tomcombriat/TES_Aurora/hardware/v1/v1.kicad_pcb

## KiCad design hardware/v1/v1.kicad_pcb (2025-04-08)

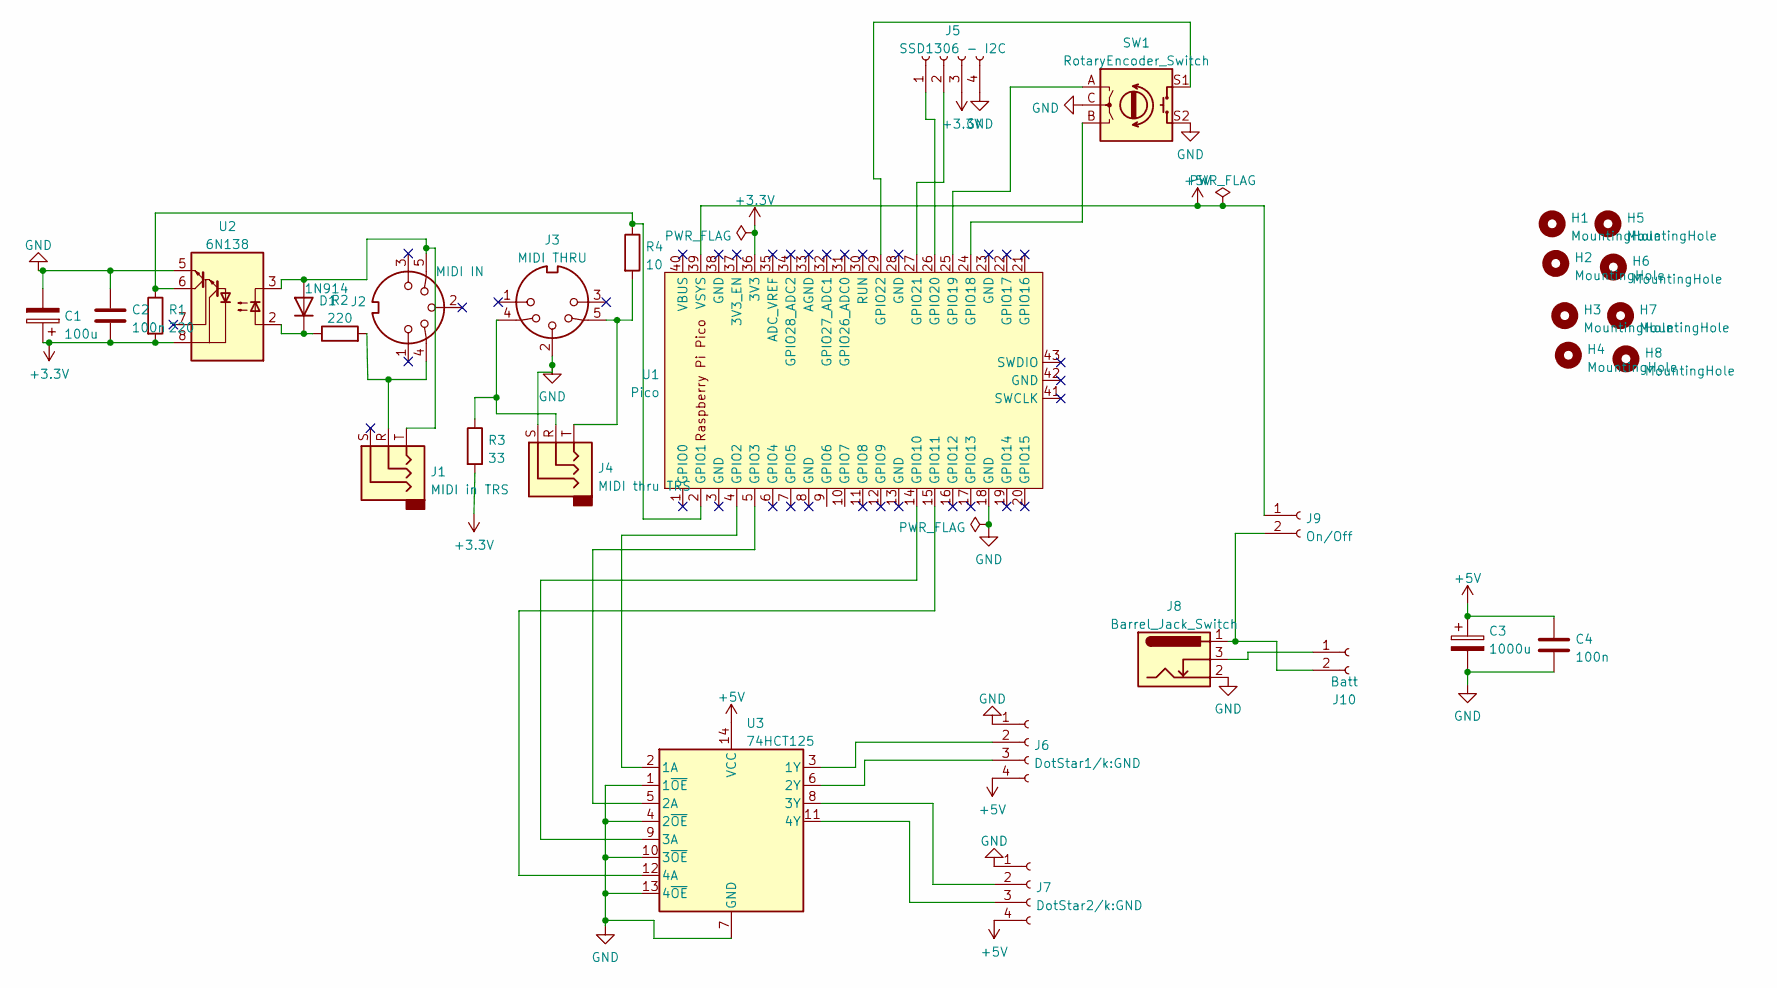
[picture p1: schematic v1.kicad_sch]

Parts:
C1: 100u; CP_Radial_D7.5mm_P2.50mm
C2, C4: 100n; C_Axial_L3.8mm_D2.6mm_P7.50mm_Horizontal
C3: 1000u; CP_Radial_D10.0mm_P5.00mm
D1: 1N914; D_DO-34_SOD68_P7.62mm_Horizontal
H1, H2, H3, H4, H5, H6, H7, H8: MountingHole; MountingHole_3.2mm_M3
J1: MIDI in TRS; PJ-320B
J2: MIDI IN; DS-5 MIDI_Wide
J3: MIDI THRU; DS-5 MIDI_Wide
J4: MIDI thru TRS; PJ-320B
J5: SSD1306 - I2C; JST_EH_B4B-EH-A_1x04_P2.50mm_Vertical
J6: DotStar1/k:GND; JST_PH_S4B-PH-K_1x04_P2.00mm_Horizontal
J7: DotStar2/k:GND; JST_PH_S4B-PH-K_1x04_P2.00mm_Horizontal
J8: Barrel_Jack_Switch; BarrelJack_CUI_PJ-102AH_Horizontal
J9: On/Off; JST_XH_B2B-XH-A_1x02_P2.50mm_Vertical
J10: Batt; JST_XH_B2B-XH-A_1x02_P2.50mm_Vertical
R1, R2: 220; R_Axial_DIN0207_L6.3mm_D2.5mm_P7.62mm_Horizontal
R3: 33; R_Axial_DIN0207_L6.3mm_D2.5mm_P7.62mm_Horizontal
R4: 10; R_Axial_DIN0207_L6.3mm_D2.5mm_P7.62mm_Horizontal
SW1: RotaryEncoder_Switch; RotaryEncoder_Alps_EC12E-Switch_Vertical_H20mm
U1: Pico; RPi_Pico_TH
U2: 6N138; DIP-8_W7.62mm_Socket
U3: 74HCT125; SOIC-14_3.9x8.7mm_P1.27mm

Connections:
+3.3V: C1.1, C2.2, J5.3, R1.2, R3.2, U1.36 (3V3), U2.8 (VCC)
+5V: C3.1, C4.2, J6.4, J7.4, J9.1, U1.39 (VSYS), U3.14 (VCC)
GND: C1.2, C2.1, C3.2, C4.1, J3.2, J4.S, J5.4, J6.1, J7.1, J8.2, SW1.C, SW1.S2, U1.18 (GND), U2.5 (GND), U3.1 (1~OE), U3.4 (2~OE), U3.7 (GND), U3.10 (3~OE), U3.13 (4~OE)
unnamed: D1.1 (K), R2.1, U2.2 (C1)
unnamed: D1.2 (A), J1.T, J2.5, U2.3 (C2)
unnamed: J1.R, J2.4, R2.2
unnamed: J3.4, J4.R, R3.1
unnamed: J3.5, J4.T, R4.2
unnamed: J6.2, U3.3 (1Y)
unnamed: J6.3, U3.6 (2Y)
unnamed: J7.2, U3.8 (3Y)
unnamed: J7.3, U3.11 (4Y)
unnamed: J8.3, J10.1
unnamed: J8.1, J9.2, J10.2
unnamed: R1.1, R4.1, U1.2 (GPIO1), U2.6 (VO2)
unnamed: U1.4 (GPIO2), U3.2 (1A)
unnamed: U1.5 (GPIO3), U3.5 (2A)
unnamed: U1.14 (GPIO10), U3.9 (3A)
unnamed: U1.15 (GPIO11), U3.12 (4A)
unnamed: SW1.B, U1.24 (GPIO18)
unnamed: SW1.A, U1.25 (GPIO19)
unnamed: J5.1, U1.26 (GPIO20)
unnamed: J5.2, U1.27 (GPIO21)
unnamed: SW1.S1, U1.29 (GPIO22)

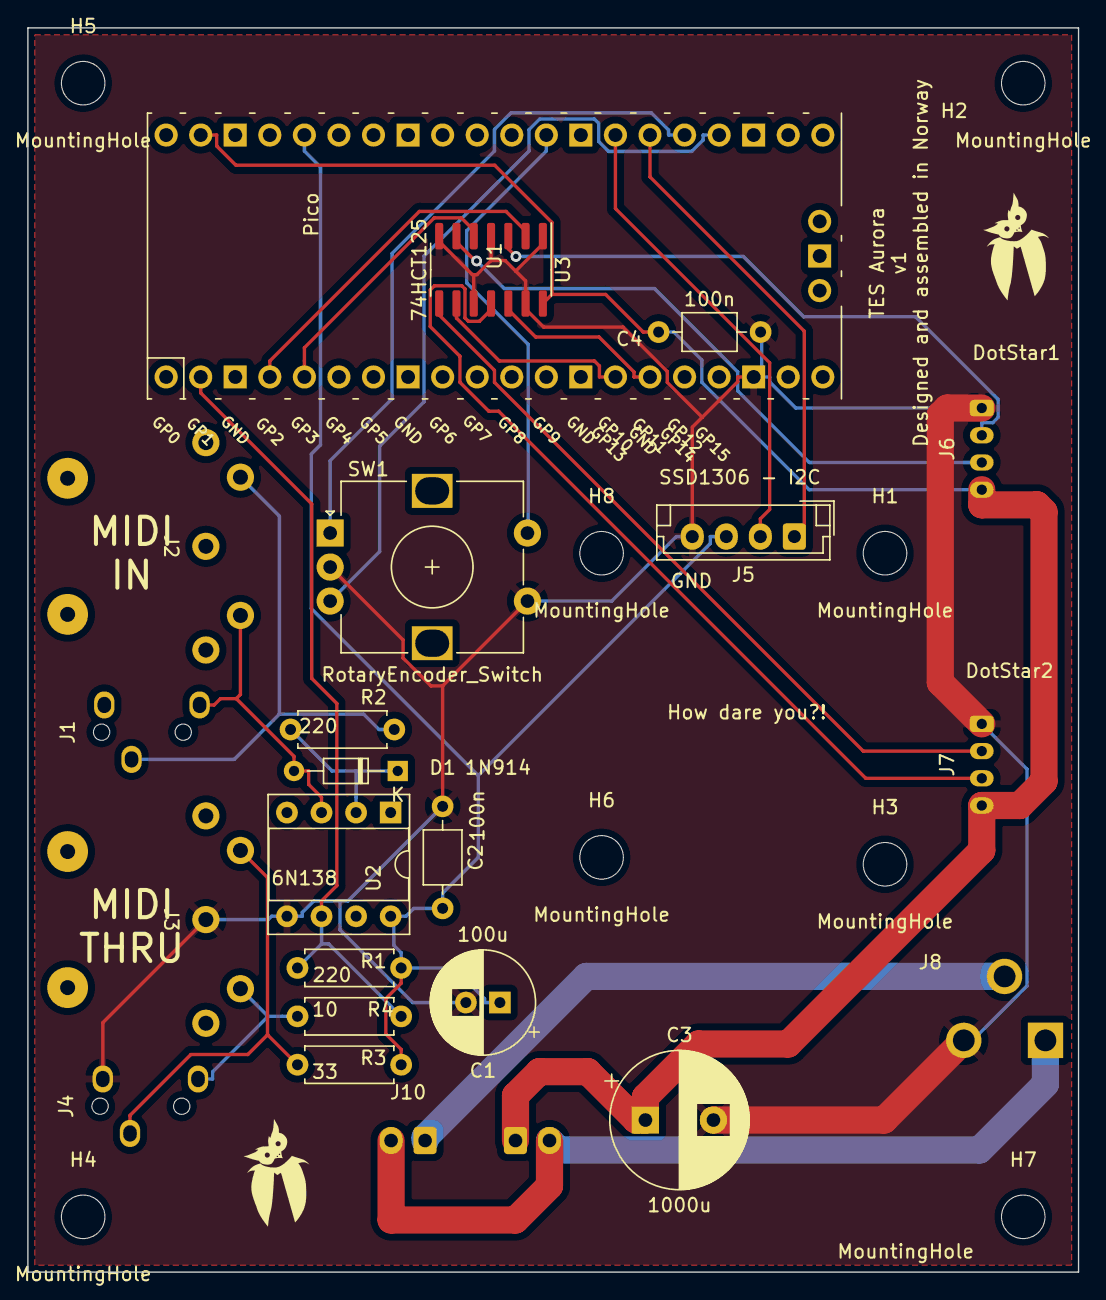
[picture p2: board v1.kicad_pcb from above]

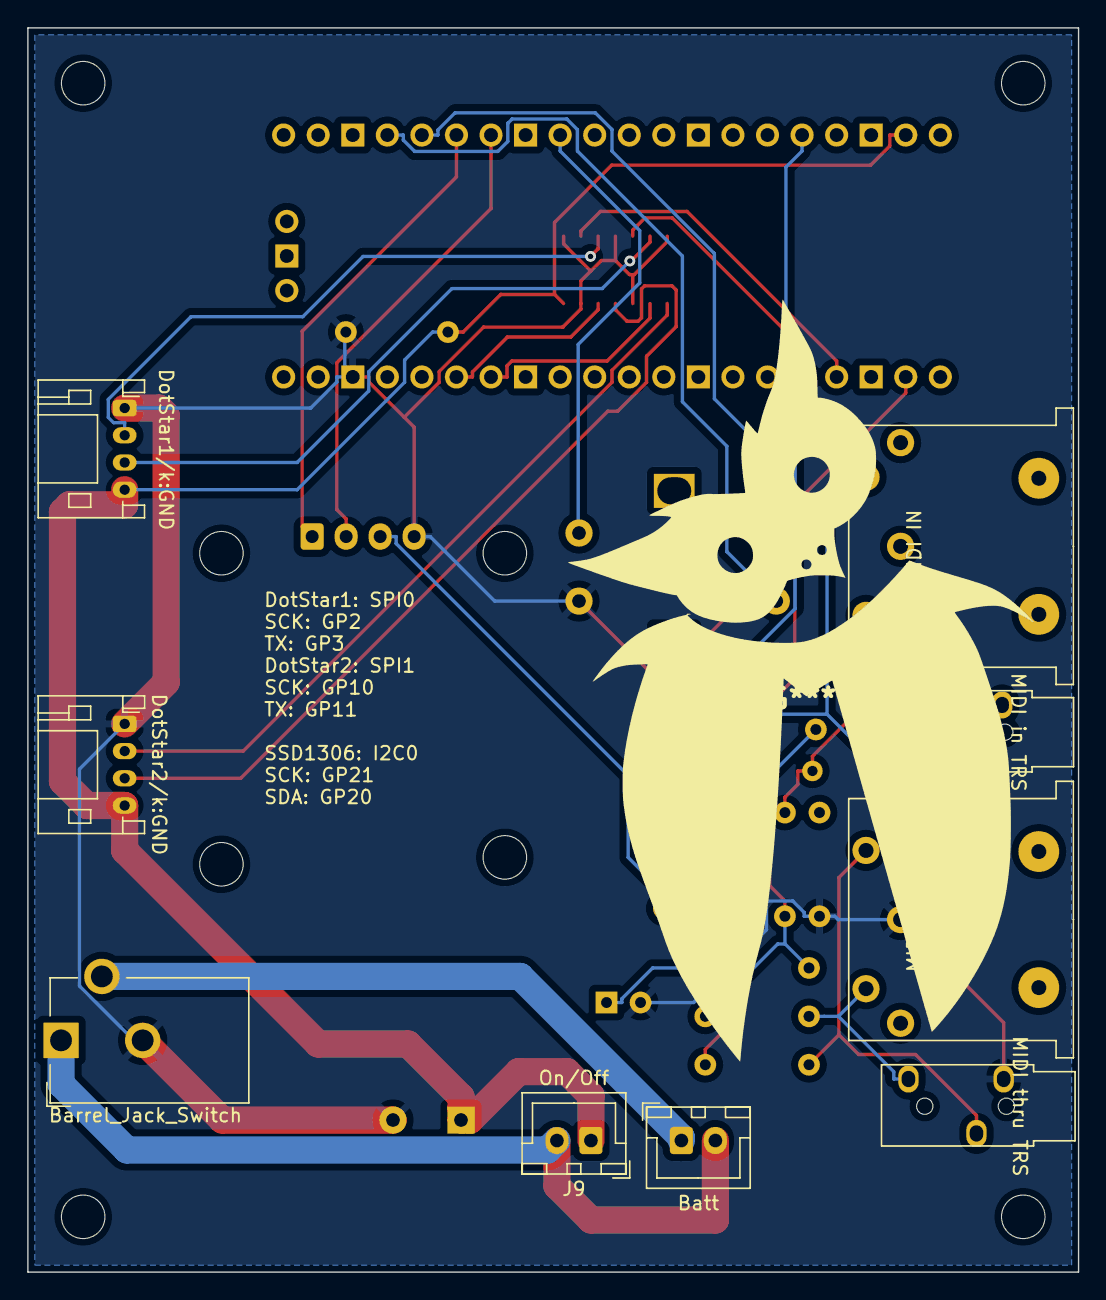
[picture p3: board v1.kicad_pcb from below]

Board: 2 copper layers, 77.2 x 91.4 mm, 33 parts (9 on the bottom side), 24 nets.

Other parts of the board:
G450, G2200: LOGO; owl_7x10
