tomcombriat/TES_Aurora/software/Aurora/Aurora.ino

#include "config.h"

#include <Adafruit_NeoPixel.h>  // for hue/hsv functions at the very least
#include <RotaryEncoder.h>
#include <Button.h>  // from TES_eSax-lib
#include <MIDI.h>
#include <EEPROM.h>
#include <SPI.h>
#include <Wire.h>
#include <Adafruit_GFX.h>
#include <Adafruit_SSD1306.h>
#include "folder.h"  // from Mozzi
#include "AuroraScreen.h"
#include "AuroraParameters.h"
#include "loaded6pt7b.h"
#include "loaded8pt7b.h"


AuroraParameters params;
//params = AuroraParameters();
uint8_t pitchbendAmplitude = 0;
uint16_t brightness = 0;  // on 14bits
uint8_t note;
int16_t pitchbend = 0;


/** ROTARY */

RotaryEncoder encoder(ROTARY_PIN1, ROTARY_PIN2, RotaryEncoder::LatchMode::FOUR3);
void checkPosition() {
  encoder.tick();  // just call tick() to check the state.
}

/** PUSH BUTTON */
Button pushButton(PUSH_BUTTON_PIN);



Adafruit_SSD1306 display(SCREEN_WIDTH, SCREEN_HEIGHT, &Wire, OLED_RESET);


AuroraScreen auroraScreen(&display, &encoder, &pushButton, &params, 100);



/** COLOR FOLDER*/
WaveFolder<uint32_t> folder;

/** STRIP*/



#if (STRIP1_TYPE == DOTSTAR)
Adafruit_DotStar strip1 = Adafruit_DotStar(STRIP1_NLED, STRIP1_COLORTYPE, &SPI);
#elif (STRIP1_TYPE == NEOPIXEL)
Adafruit_NeoPixel strip1 = Adafruit_NeoPixel(STRIP1_NLED, STRIP1_TX, STRIP1_COLORTYPE);
#endif


#if (STRIP2_TYPE == DOTSTAR)
Adafruit_DotStar strip2 = Adafruit_DotStar(STRIP2_NLED, STRIP2_COLORTYPE, &SPI1);
#elif (STRIP2_TYPE == NEOPIXEL)
Adafruit_NeoPixel strip2 = Adafruit_NeoPixel(STRIP2_NLED, STRIP2_TX, STRIP2_COLORTYPE);
#endif



uint32_t color1[STRIP1_NLED];
uint32_t color2[STRIP2_NLED];
unsigned long next_update = 0;

void handleCC(byte _channel, byte control1, byte control2) {
  if (_channel == params.midi_channel && control1 == params.midi_control_MSB) {
    brightness &= 0b00000001111111;
    brightness += control2 << 7;
  }
  if (_channel == params.midi_channel && control1 == params.midi_control_LSB) {
    brightness &= 0b11111110000000;
    brightness += control2;
    //Serial.println(control2);
  } else if (_channel == params.midi_channel && control1 == params.midi_pitchbend_amplitude_control) pitchbendAmplitude = control2;
}

void handleNoteOn(byte _channel, byte _note, byte _velocity) {
  if (_channel == params.midi_channel) {
    note = _note;
    brightness = _velocity << 7;
  }
}

void handleNoteOff(byte channel, byte note, byte velocity) {
  if (channel == params.midi_channel) {
    brightness = 0;
  }
}

void handlePitchBend(byte _channel, int _pitchbend) {
  if (_channel == params.midi_channel) {
    pitchbend = _pitchbend;
  }
}


MIDI_CREATE_INSTANCE(HardwareSerial, Serial1, MIDI);

void setup() {
  //Serial.begin(115200);
  EEPROM.begin(256);
  if (pushButton.is_pressed()) EEPROM.put(0, params);  // factory reset
  else EEPROM.get(0, params);


  pinMode(LED_BUILTIN, OUTPUT);

  attachInterrupt(digitalPinToInterrupt(ROTARY_PIN1), checkPosition, CHANGE);
  attachInterrupt(digitalPinToInterrupt(ROTARY_PIN2), checkPosition, CHANGE);

  Serial.begin(115200);
  Serial1.setRX(1);

  MIDI.setHandleControlChange(handleCC);
  MIDI.setHandleNoteOn(handleNoteOn);
  MIDI.setHandleNoteOff(handleNoteOff);
  MIDI.setHandlePitchBend(handlePitchBend);
  MIDI.turnThruOff();  // done in hw
  MIDI.begin(MIDI_CHANNEL_OMNI);


  // SPI.setSCK(2);
  // SPI.setTX(3);
  //strip2.begin();
  // strip2.setBrightness(255);
  // strip2.show();  // Initialize all pixels to 'off'

#if (STRIP1_TYPE == DOTSTAR)
  SPI.setSCK(STRIP1_SCK);
  SPI.setTX(STRIP1_TX);
#endif

#if (STRIP2_TYPE == DOTSTAR)
  SPI1.setSCK(STRIP2_SCK);
  SPI1.setTX(STRIP2_TX);
#endif

#if (STRIP1_TYPE != NONE)
  strip1.begin();
  strip1.setBrightness(255);
  strip1.show();  // Initialize all pixels to 'off'
#endif

#if (STRIP2_TYPE != NONE)
  strip2.begin();
  strip2.setBrightness(255);
  strip2.show();  // Initialize all pixels to 'off'
#endif



  folder.setLimits(params.lowest_hue, params.highest_hue);

  Wire.setSDA(SCREEN_SDA);
  Wire.setSCL(SCREEN_SCL);
  display.begin(SSD1306_SWITCHCAPVCC, SCREEN_ADDRESS);
  display.clearDisplay();
  display.setTextColor(SSD1306_WHITE);
  display.setTextSize(2);
  display.setCursor(30, 20);
  display.setFont(&loaded8pt7b);
  display.print("TES");
  display.setFont(&loaded6pt7b);
  display.setTextSize(1);
  display.setCursor(50, 40);
  display.print("Aurora v1");
  display.setCursor(0, 63);
  display.print("Pwd by Adafruit");
  display.display();
  delay(500);
}









void loop() {


  if (millis() > next_update) {
    next_update += params.period;
    /*Serial.print((uint16_t((note) << 10) + ((pitchbend * pitchbendAmplitude) >> 3)));
Serial.print(" ");
Serial.println(folder.next(uint16_t(((note) << 10) + ((pitchbend * pitchbendAmplitude) >> 3))));*/
    uint32_t color = Adafruit_NeoPixel::gamma32(Adafruit_NeoPixel::ColorHSV(folder.next(((note) << 10) + ((pitchbend * pitchbendAmplitude) >> 3)), params.global_saturation,params.global_brightness));

    // color1[0] = strip1.gamma32(strip1.ColorHSV(folder.next(((note) << 10) + ((pitchbend * pitchbendAmplitude) >> 3))));  //, 255, brightness >> 6)); // with gamma on the value

    // This is to have more dynamic range on the brightness (other, colors get averaged to 0 at low dynamic because of the gamma32)
    uint8_t r = (uint8_t)(color >> 16), g = (uint8_t)(color >> 8), b = (uint8_t)color;
    uint8_t br = brightness >> 6;
    r = (r * br) >> 8;
    g = (g * br) >> 8;
    b = (b * br) >> 8;
    color = b + (g << 8) + (r << 16);

#if (STRIP1_TYPE != NONE)
    strip1.setPixelColor(0, color);
    color1[0] = color;
#endif
#if (STRIP2_TYPE != NONE)
    strip2.setPixelColor(0, color);
    color2[0] = color;
#endif

    for (uint8_t s = 0; s < params.speeder; s++) {
#if (STRIP1_TYPE != NONE)
      for (int i = STRIP1_NLED - 1; i > 0; i--) {
        color1[i] = color1[i - 1];  // propagation
        if (s == params.speeder - 1) {
          strip1.setPixelColor(i, color1[i]);
          //strip2.setPixelColor(i, color1[i]);
        }
      }
#endif

#if (STRIP2_TYPE != NONE)
      for (int i = STRIP2_NLED - 1; i > 0; i--) {
        color2[i] = color2[i - 1];  // propagation

        if (s == params.speeder - 1) {
          strip2.setPixelColor(i, color2[i]);
        }
      }
#endif
    }

#if (STRIP1_TYPE != NONE)
    strip1.show();
#endif
#if (STRIP2_TYPE != NONE)
    //digitalWrite(LED_BUILTIN, !digitalRead(LED_BUILTIN));
    strip2.show();
#endif
  }
}

void loop1() {

  while (MIDI.read())
    ;

  auroraScreen.update();

  /* display.clearDisplay();
  display.setTextColor(SSD1306_WHITE);
  display.setCursor(0, 0);
  display.print("Coucou");
  display.display();
  delay(20);*/
  /* Serial.print(note);
  Serial.print(" ");
  Serial.print(brightness);
  Serial.print(" ");
  Serial.println(color[0]);*/
  /*pushButton.update();
  if (pushButton.is_pressed()) digitalWrite(LED_BUILTIN,HIGH);
  else digitalWrite(LED_BUILTIN,LOW);*/
}
