tomcombriat/TES_Aurora/software/Aurora/loaded8pt7b.h

const uint8_t loaded8pt7bBitmaps[] PROGMEM = {
  0x00, 0xFF, 0xFC, 0x3C, 0xCF, 0x3C, 0xF3, 0xCC, 0x63, 0x31, 0xBF, 0xFF,
  0xF6, 0x33, 0x19, 0x8D, 0xFF, 0xFF, 0xB1, 0x98, 0xC0, 0x0C, 0x1F, 0xFF,
  0xFF, 0x30, 0xCC, 0x3F, 0xEF, 0xF8, 0x36, 0x0D, 0xBF, 0xEF, 0xF0, 0x73,
  0xF9, 0xFD, 0xDE, 0xC0, 0xE0, 0xE0, 0x60, 0x77, 0x73, 0xB9, 0xF8, 0xE0,
  0x7E, 0x3F, 0xCC, 0x33, 0xCC, 0x7A, 0x1F, 0xBD, 0xFF, 0x1F, 0xFF, 0x9F,
  0xC0, 0xFF, 0xFE, 0x7F, 0x6D, 0xB6, 0xEC, 0xDD, 0xB6, 0xDB, 0xF8, 0xCD,
  0xE7, 0xBF, 0xFD, 0xEC, 0xC0, 0x18, 0x18, 0x18, 0xFF, 0xFF, 0x18, 0x18,
  0x18, 0x18, 0xF4, 0xFF, 0xF0, 0x01, 0xC0, 0xE0, 0x70, 0x1C, 0x0E, 0x03,
  0x01, 0xC0, 0xE0, 0x38, 0x1C, 0x0E, 0x00, 0x7F, 0x7F, 0xF0, 0x78, 0x3C,
  0x1E, 0x0F, 0x07, 0x83, 0xFF, 0xBF, 0xC0, 0x7F, 0xB6, 0xDB, 0x6D, 0x80,
  0xFF, 0x7F, 0xC0, 0x60, 0x37, 0xFF, 0xFF, 0x01, 0x80, 0xFF, 0xFF, 0xC0,
  0xFF, 0x7F, 0xC0, 0x60, 0x3F, 0xF7, 0xF8, 0x06, 0x03, 0xFF, 0xFF, 0x80,
  0xC1, 0xE0, 0xF0, 0x78, 0x3C, 0x1F, 0xFD, 0xFE, 0x03, 0x01, 0x80, 0xC0,
  0x60, 0xFF, 0xFF, 0xF0, 0x18, 0x0F, 0xFB, 0xFC, 0x06, 0x03, 0xFF, 0xFF,
  0x80, 0x7F, 0xFF, 0xF0, 0x18, 0x0F, 0xF7, 0xFF, 0x07, 0x83, 0xFF, 0xBF,
  0x80, 0xFF, 0xFF, 0xF0, 0x38, 0x0E, 0x07, 0x03, 0x80, 0xE0, 0x70, 0x1C,
  0x0E, 0x00, 0x7F, 0x7F, 0xF0, 0x78, 0x37, 0xF3, 0xFB, 0x07, 0x83, 0xFF,
  0xBF, 0x80, 0x7F, 0x7F, 0xF0, 0x78, 0x3F, 0xFB, 0xFC, 0x06, 0x03, 0xFF,
  0xFF, 0x80, 0xF0, 0x3C, 0xF0, 0x3D, 0x17, 0xFC, 0xF7, 0x10, 0xFF, 0xFC,
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
  {   321,   8,  10,  10,    1,   -9 },   // 0x46 'F'
  {   331,   9,  10,  11,    1,   -9 },   // 0x47 'G'
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

const GFXfont loaded8pt7b PROGMEM = {
  (uint8_t  *)loaded8pt7bBitmaps,
  (GFXglyph *)loaded8pt7bGlyphs,
  0x20, 0x7E, 15 };

// Approx. 1595 bytes
