tomcombriat/TES_Aurora/software/Aurora/loaded4pt7b.h

const uint8_t loaded4pt7bBitmaps[] PROGMEM = {
  0x00, 0xFC, 0xC0, 0xFC, 0x5F, 0xD7, 0xF5, 0x80, 0xFF, 0x3E, 0x5F, 0x80,
  0xDE, 0x88, 0xFD, 0x80, 0xF3, 0x47, 0xF7, 0x78, 0xF0, 0xFF, 0x40, 0xD5,
  0xC0, 0xFF, 0xF0, 0x21, 0x3E, 0x42, 0x00, 0xD0, 0xC0, 0xC0, 0x19, 0x88,
  0x8C, 0x00, 0xFE, 0x73, 0x97, 0x80, 0xD5, 0x40, 0xF8, 0x7F, 0x8F, 0x80,
  0xF8, 0x5E, 0x1F, 0x80, 0xCE, 0x5E, 0x10, 0x80, 0xFE, 0x1E, 0x1F, 0x80,
  0xFE, 0x3F, 0x9F, 0x80, 0xF8, 0xC4, 0x66, 0x00, 0xFE, 0x5F, 0x97, 0x80,
  0xFE, 0x5E, 0x1F, 0x80, 0xF3, 0xF3, 0x40, 0x3F, 0x10, 0xFF, 0x9D, 0xC0,
  0xFE, 0x4E, 0x02, 0x00, 0xFF, 0xFB, 0xF7, 0x80, 0xF8, 0x7B, 0x97, 0x80,
  0xFE, 0x7F, 0x9F, 0x80, 0xFE, 0x31, 0x87, 0x80, 0xFE, 0x73, 0x9D, 0x80,
  0xFE, 0x7F, 0x87, 0x80, 0xFC, 0x2F, 0x08, 0x00, 0xFE, 0x3F, 0x97, 0x80,
  0xCE, 0x7B, 0x9C, 0x80, 0xFF, 0xC0, 0x11, 0x11, 0xF0, 0xDF, 0xB9, 0xAD,
  0x80, 0xCC, 0xCC, 0xF0, 0xDF, 0xFB, 0x9C, 0x80, 0xCF, 0x7F, 0xBC, 0x80,
  0xFE, 0x73, 0x97, 0x80, 0xFE, 0x7F, 0x8C, 0x00, 0xFB, 0x2C, 0xB2, 0x7C,
  0xFE, 0x7F, 0xAD, 0x80, 0xFE, 0x3E, 0x1F, 0x80, 0xF9, 0x08, 0x42, 0x00,
  0xCE, 0x73, 0x97, 0x80, 0xCA, 0x54, 0x63, 0x00, 0xCE, 0x7B, 0xFC, 0x80,
  0xCB, 0x8C, 0xFC, 0x80, 0xCB, 0x88, 0x42, 0x00, 0xF8, 0x88, 0xCF, 0x80,
  0xFF, 0x40, 0xC3, 0x08, 0x21, 0x80, 0xD5, 0xC0, 0x6D, 0xF0, 0x00, 0xF8,
  0x7B, 0x97, 0x80, 0xFE, 0x7F, 0x9F, 0x80, 0xFE, 0x31, 0x87, 0x80, 0xFE,
  0x73, 0x9D, 0x80, 0xFE, 0x7F, 0x87, 0x80, 0xFC, 0x2F, 0x08, 0x00, 0xFE,
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
  {   112,   5,   5,   5,    0,   -4 },   // 0x46 'F'
  {   116,   5,   5,   5,    0,   -4 },   // 0x47 'G'
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

const GFXfont loaded4pt7b PROGMEM = {
  (uint8_t  *)loaded4pt7bBitmaps,
  (GFXglyph *)loaded4pt7bGlyphs,
  0x20, 0x7E, 7 };

// Approx. 980 bytes
