tomcombriat/TES_Aurora/software/Aurora/loaded5pt7b.h

const uint8_t loaded5pt7bBitmaps[] PROGMEM = {
  0x00, 0xFF, 0x3C, 0xFF, 0x80, 0x6D, 0xFF, 0xFB, 0x6F, 0xFF, 0xDB, 0x00,
  0xFD, 0xFB, 0x47, 0xFF, 0xFF, 0xFF, 0x80, 0xCF, 0x63, 0x08, 0x63, 0x7D,
  0x80, 0xF3, 0xC9, 0x18, 0x9F, 0xFF, 0x80, 0xFC, 0xFB, 0x6F, 0xC0, 0xFD,
  0xB7, 0xF8, 0xBF, 0xFA, 0x21, 0x3E, 0x42, 0x00, 0xD0, 0xE0, 0xC0, 0x0C,
  0x61, 0x8C, 0x21, 0x8C, 0x00, 0xFF, 0xE3, 0x18, 0xFF, 0xE0, 0x75, 0x54,
  0xFF, 0xC7, 0xFF, 0xFF, 0xE0, 0xFF, 0xF0, 0xFF, 0xFF, 0xFF, 0xC0, 0xDE,
  0xF7, 0xFF, 0x8C, 0x60, 0xFE, 0x3E, 0x3F, 0xFC, 0xFF, 0xFC, 0x3E, 0xFB,
  0xEF, 0x80, 0xFF, 0xF1, 0x86, 0x30, 0x86, 0x00, 0xFF, 0xF6, 0xFF, 0xFF,
  0xE0, 0xFF, 0xF7, 0xFF, 0xFF, 0xE0, 0xC3, 0xC3, 0x40, 0x7B, 0x40, 0xF0,
  0xF0, 0xB7, 0x80, 0xFF, 0xFF, 0x18, 0xF1, 0xE3, 0x06, 0x00, 0xFF, 0xFF,
  0xBF, 0xFF, 0xE0, 0xF8, 0xFF, 0x39, 0xFC, 0xFF, 0xFC, 0xFF, 0xFF, 0xFF,
  0xC0, 0xFF, 0xFC, 0x30, 0xC3, 0xFF, 0xC0, 0xFF, 0xF7, 0xBD, 0xEF, 0xE0,
  0xFF, 0xE3, 0x7B, 0xFF, 0xE0, 0xFC, 0x2F, 0x08, 0x40, 0xFF, 0xE1, 0x78,
  0xFF, 0xE0, 0xCE, 0x73, 0xFF, 0xE7, 0x20, 0xFE, 0x11, 0x11, 0x1F, 0xF0,
  0xCF, 0x2D, 0xBC, 0xDB, 0x2C, 0xC0, 0x88, 0x88, 0x88, 0xF0, 0xDE, 0xFF,
  0xFD, 0xEF, 0x60, 0xDE, 0xFF, 0xFF, 0xEF, 0x60, 0xFF, 0xE3, 0x18, 0xDE,
  0xE0, 0xFF, 0xF7, 0xFF, 0xE3, 0x00, 0xFD, 0xFB, 0x36, 0x6C, 0xDF, 0xFF,
  0x80, 0xFF, 0xF3, 0xFF, 0xEB, 0x60, 0xFC, 0x3F, 0xFF, 0xFC, 0xFF, 0xF3,
  0x0C, 0x30, 0xC3, 0x00, 0x8C, 0x63, 0x18, 0xC6, 0xE0, 0xC6, 0x89, 0x93,
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
  {   149,   5,   6,   6,    1,   -5 },   // 0x46 'F'
  {   153,   5,   7,   7,    1,   -6 },   // 0x47 'G'
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

const GFXfont loaded5pt7b PROGMEM = {
  (uint8_t  *)loaded5pt7bBitmaps,
  (GFXglyph *)loaded5pt7bGlyphs,
  0x20, 0x7E, 9 };

// Approx. 1079 bytes
