tomcombriat/TES_Aurora/software/Aurora/loaded6pt7b.h

const uint8_t loaded6pt7bBitmaps[] PROGMEM = {
  0x00, 0xFF, 0xCF, 0xFF, 0xF0, 0x6D, 0xFF, 0xFB, 0x66, 0xDF, 0xFF, 0xB6,
  0xFF, 0xFF, 0x47, 0xFF, 0xE2, 0xFF, 0xFF, 0xC7, 0x9B, 0x60, 0xC3, 0x0D,
  0xDB, 0xE6, 0xFE, 0x7F, 0x31, 0x8E, 0x8F, 0xDE, 0x7F, 0xFF, 0xFE, 0xFC,
  0xFF, 0x6D, 0xBF, 0xFD, 0xB6, 0xFF, 0x96, 0xF6, 0x90, 0x18, 0x18, 0x18,
  0xFF, 0xFF, 0x18, 0x18, 0xF4, 0xC0, 0xF0, 0x06, 0x18, 0x30, 0xC3, 0x86,
  0x18, 0x70, 0xFF, 0xFF, 0x1E, 0x3C, 0x78, 0xFF, 0xFF, 0xFD, 0xB6, 0xDB,
  0xFF, 0xF0, 0xFF, 0xFF, 0x0F, 0xFF, 0xFF, 0xFC, 0x1F, 0xFF, 0xE0, 0xFF,
  0xFF, 0xCF, 0x3C, 0xFF, 0xFC, 0x30, 0xC3, 0xFF, 0xFC, 0x3F, 0xFC, 0x3F,
  0xFF, 0xFF, 0xFF, 0x07, 0xEF, 0xD9, 0xBF, 0x7E, 0xFF, 0xFC, 0x38, 0x61,
  0x83, 0x0C, 0x38, 0xFF, 0xFC, 0xFF, 0xFF, 0x3F, 0xFF, 0xFF, 0xFC, 0xFF,
  0xFC, 0x3F, 0xFF, 0xF3, 0xC0, 0xF3, 0xD0, 0x3E, 0x72, 0xF8, 0x3E, 0x9D,
  0xF8, 0xFF, 0xFF, 0x19, 0xF3, 0xE0, 0x0C, 0x18, 0xFF, 0xFC, 0xFF, 0xEF,
  0xFF, 0xFF, 0xFF, 0xF0, 0xFF, 0xFF, 0x3F, 0xFF, 0xFF, 0xFC, 0xFF, 0xFF,
  0x3F, 0xFF, 0xFF, 0xFF, 0x06, 0x0C, 0x18, 0x3F, 0xFF, 0xFF, 0xFF, 0x1E,
  0x3C, 0x78, 0xF7, 0xEF, 0xFF, 0xFC, 0xFF, 0xFF, 0x0F, 0xFF, 0xFF, 0xFF,
  0x06, 0xFD, 0xF8, 0x30, 0x60, 0xFF, 0xFC, 0x3F, 0xFF, 0x3F, 0xFF, 0xCF,
  0x3C, 0xFF, 0xFF, 0x3C, 0xF3, 0xFF, 0xFF, 0x0C, 0x30, 0xC3, 0x0C, 0x3F,
  0xFF, 0xCF, 0x9B, 0x67, 0x8F, 0x1B, 0x33, 0x67, 0xC3, 0x0C, 0x30, 0xC3,
  0x0F, 0xFF, 0xCF, 0xFF, 0xFF, 0xEF, 0x3C, 0xF3, 0xC7, 0xCF, 0xDF, 0xBD,
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
  {   178,   7,   8,   7,    0,   -7 },   // 0x46 'F'
  {   185,   6,   8,   8,    1,   -7 },   // 0x47 'G'
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

const GFXfont loaded6pt7b PROGMEM = {
  (uint8_t  *)loaded6pt7bBitmaps,
  (GFXglyph *)loaded6pt7bGlyphs,
  0x20, 0x7E, 11 };

// Approx. 1172 bytes
