tomcombriat/TES_Aurora/(commit log)

2025-04-06 Added Pico lib for kicad
2025-04-06 Started kicad proj
    [v1.kicad_pcb, v1.kicad_sch]
2025-04-06 Started schema
    [v1.kicad_sch]
2025-04-08 Schem and PCB
    [v1.kicad_pcb, v1.kicad_sch]
2025-04-08 Added gerber file
    [v1-B_Cu.gbr, v1-B_Mask.gbr, v1-B_Paste.gbr, v1-B_Silkscreen.gbr, v1-Edge_Cuts.gbr, v1-F_Cu.gbr, v1-F_Mask.gbr, v1-F_Paste.gbr]
2025-04-08 Putting switch on bottom
    [v1-B_Cu.gbr, v1-B_Mask.gbr, v1-B_Paste.gbr, v1-B_Silkscreen.gbr, v1-Edge_Cuts.gbr, v1-F_Cu.gbr, v1-F_Mask.gbr, v1-F_Paste.gbr]
2025-04-27 MIDI sensing and wave prop
2025-09-10 Corrected out of bound array accessing in color
    [config.h]
